Unmolsharma/QKDCubesat-TimingSync-FPGA/(commit log)

2026-09-26 Step 1: carry-chain delay line model, sync stage, popcount encoder
    - tdc_delay_line: CARRY4+FDRE under `ifdef SYNTHESIS (hit enters via CYINIT,
    the only fabric-reachable carry input on 7-series); seeded behavioural
    threshold model otherwise (22 ps nominal, wide/near-zero bins, per-tap
    skew -> bubbles, per-sample jitter)
    - tdc_sync: second register stage (ASYNC_REG)
    - tdc_encoder: 3-stage pipelined popcount (bubble-tolerant)
    - tdc_frontend: wraps the above with aligned t0/zero/full flags
    - cocotb runner (no make) with default / nojitter / fast_corner configs
    - tests: smoke, sweep/monotonicity, coverage (fast corner is an expected
    failure demonstrating that 192 taps do not always cover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
    [tdc_delay_line.v, tdc_encoder.v, tdc_frontend.v, tdc_sync.v]
2026-09-26 Step 2: coarse counter, hit detector, calibration LUT hook, tdc_top
    - tdc_coarse_counter: free-running, delayed to match the frontend latency
    - tdc_hit_detect: tap-0 trigger, holds the candidate until the line is seen
    full (proves pulse > chain; short pulses flagged, never emitted),
    saturation (coverage) and re-trigger counters, dead-time handling
    - tdc_calib_lut: fine -> ps, ideal linear default, $readmemh, runtime write
    - tdc_top: valid/ready stream {coarse,fine} + {coarse,fine_ps}, drop+count
    - delay-line model: mask/binary-search evaluation (bit-identical, faster)
    - tests: smoke, boundary, multi-hit + dead time, short pulse, back-pressure,
    top-level coverage, code-density data coll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
    [tdc_calib_lut.v, tdc_coarse_counter.v, tdc_delay_line.v, tdc_frontend.v, tdc_hit_detect.v, tdc_top.v]
2026-09-26 Step 3: code-density calibration, analysis, simulated results
    - scripts/calibrate.py: code-density test -> bin widths, DNL, INL,
    bin-centre LUT (.mem for $readmemh); simple one-code-per-line input
    - scripts/analyze.py: histogram, widths (vs model ground truth), DNL, INL,
    RMS before/after calibration validated on an independent data set
    - runner: "calibrated" config loads the generated LUT into the RTL and
    checks it end to end; tighter boundary tolerance
    - README: architecture, time convention, assumptions, coverage risk,
    SIMULATED results table (calibrated RMS 11.7 ps, residual INL 0.29 LSB)
    [analyze.py, calibrate.py]
2026-09-26 Step 4: UART readout, ring-oscillator hit source, board wrapper, capture.py
    - tdc_uart_tx / tdc_uart_readout: 2 Mbaud 8N1 (exact from 250 MHz),
    self-synchronising frames (FINE / TIMESTAMP / STATUS), BRAM FIFO,
    back-pressure -> drop+count in tdc_top, periodic status frames
    - tdc_ring_osc: LUT ring + ripple divider (DONT_TOUCH, combinational-loop
    notes), simulation stand-in behind `ifndef SYNTHESIS
    - tdc_arty_top: MMCM 100->250 MHz, sw0 hit source, sw1 UART mode,
    sticky drop/short/saturation LEDs
    - scripts/capture.py: pyserial capture + offline re-parse -> calibrate.py CSV
    - tests: timestamp burst with FIFO overflow (frames == TDC stream, sent +
    dropped == hits, capture.py CLI on the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
    [capture.py, tdc_arty_top.v, tdc_ring_osc.v, tdc_uart_readout.v, tdc_uart_tx.v]
2026-09-26 Step 5: XDC, chain placement, Vivado build script, lab guide
    - constraints/tdc_arty_a7.xdc: board + MMCM clocks, ring-oscillator clock
    and combinational-loop waiver, false path through the chain's CYINIT
    (with rationale), DONT_TOUCH/ASYNC_REG, single-column single-region
    pblock, Arty A7 pins
    - constraints/tdc_chain_place.tcl: LOC/BEL for every CARRY4 and capture FF
    derived from the pblock; post-route contiguity/clock-region check
    - scripts/build.tcl: portable non-project flow (part=/lut= args), reports,
    chain_placement.rpt, summary.txt with WNS/Fmax, bitstream
    - docs/LAB_BUILD.md, sim/Makefile, README readout + spec-deviation notes,
    results refreshed from a clean full regression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
    [tdc_arty_a7.xdc]
2026-10-06 Step 0: restructure for block 2, chain-delay report in build.tcl
    - Block 1 RTL moves to rtl/tdc/, board wrapper + UART to rtl/top/,
    block 1 tests to sim/tdc/. New dirs for rtl/nco, sim/nco,
    sim/integration and model/ (Python reference models).
    - run_tests.py: RTL is every .v under rtl/; suites carry their block
    directory; new --block filter. Full block 1 regression passes
    unchanged after the move (same missing-code and coverage numbers).
    - build.tcl: reads rtl/*/*.v; after routing, sums the static-timing
    delay CYINIT(#0) -> CO[3](#47) at the fast corner (min) and slow
    corner (max), writes build/reports/chain_delay.rpt with a per-CARRY4
    breakdown and a report_timing cross-check,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
    [calibrate.py, capture.py, tdc_arty_top.v, tdc_calib_lut.v, tdc_coarse_counter.v, tdc_delay_line.v, tdc_encoder.v]
2026-10-19 Block 2 step 1: float loop model, gain choice, acquisition and Doppler sweeps
    model/hitgen.py: sparse photon stream generator (ppm offset + Doppler ramp,
    per-slot detection probability down to 1e-5, Gaussian jitter, dark counts,
    signal gaps, TDC dead time, offered vs accepted rates).
    model/loop_float.py: per-hit type-2 PI loop with shift-only gains
    (Ki = Kp^2/2), hit-rate gain scaling, noise gate, e^2 lock detector and
    signed-error slip detector, plus the sweeps and plots (all SIMULATED):
    - lock success / time vs detection rate at +/-100 ppm and +/-1 ppm
    - max tracking error vs accepted rate for a 0.4 ppm/s ramp at 500 MHz
    - a typical lock trace
    Design changes the model forced (documented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
2026-10-19 Block 2 step 2: bit- and cycle-exact fixed-point loop model
    model/loop_fixed.py is the golden reference the RTL must match on every hit.
    It pins all widths (88-bit phase = 48-bit slot + 40 fraction; frequency in
    slots/ps, signed 48 bit, 2^-56, so phase interpolation is one multiply;
    25-bit phase error; 32-bit e^2 average), round-half-up on every dropped bit
    except three documented floor truncations, and the exact cycle on which each
    register changes (release rule, 6-cycle correction latency, POP_GAP = 2 so
    each hit sees the previous hit's decisions, per-cycle no-hit timeout).
    Sanity run on generated streams agrees with the float model: lock after
    ~420 hits, one constant slot offset after lo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
2026-10-19 Block 2 step 3: NCO RTL (align, core, phase det, gate, loop filter, lock det) + tests
    rtl/nco/: nco_align (hold-until-due FIFO, exact late release fine' = fine +
    j*T up to J_MAX = 12, POP_GAP = 2, late count), nco_core (88-bit phase,
    frequency in slots/ps, constant x4000 increment, documented valid-strobed
    external correction port), nco_phase_det (one 25x17 multiply, wrap, slot,
    e^2, residual ps), nco_gate (2g ceiling documented), nco_loop_filter (shift-
    only PI, Ki = Kp^2/2, gear ramp, power-of-two hit-rate scaling with
    override), nco_lock_det (ACQ/RAMP/LOCK, dual-weight e^2 average, reject run,
    per-cycle no-hit timeout, signed-error slip suspicion forcing unlock,
    counters), nco_top (valid/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
    [nco_align.v, nco_core.v, nco_gate.v, nco_lock_det.v, nco_loop_filter.v, nco_phase_det.v, nco_tb_top.v]
2026-10-19 Block 2 step 4: 48-bit TDC time base, telemetry framing, TDC->NCO integration, README
    - tdc_coarse_counter / tdc_top / tdc_hit_detect: COARSE_W 32 -> 48 (wraps after
    13 days instead of 17.2 s, so every timestamp of a ~6 min pass is unique).
    Block 1 tests are width-generic and pass unchanged.
    - tdc_uart_readout: TIMESTAMP frame 7 -> 9 bytes (48-bit coarse); new type 3
    TELEMETRY frame (25 bytes, 173-bit loop state/frequency/averages/counters),
    sent after each STATUS frame when tlm_en is set (tied off in the block 1
    wrapper). scripts/capture.py decodes it (--tlm-out, --f-src).
    - sim/integration: behavioural carry-chain TDC -> nco_top through the
    valid/ready interface, NCO time base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
2026-10-20 Block 2: operating limits (jitter, dark counts, SPAD tail) from the float model
    model/hitgen.py: optional SPAD diffusion tail (tail_frac of detections get an
    extra exponential delay, mean tail_tau_ps). Off by default; streams without
    it are unchanged (NCO RTL suite re-run: all PASS, still bit-exact).
    model/loop_limits.py (SIMULATED, 16 trials/point, +/-100 ppm, ~1e5 photons/s):
    - max photon jitter that locks with 0 slips: 100 MHz 1200 ps default /
    1600 ps tuned; 500 MHz 210 ps default / 350 ps tuned (tuned = gate 1/4,
    lock 1/20, unlock 0.07; runtime inputs only). 150 ps Si SPAD at 500 MHz:
    100 % lock, 0 slips, but the default gate flags ~10 % of real photons ->
    use gate 1/4 for M2.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
2026-10-20 Phase 2 step 1: satellite emulator on its own clock + statistics test
    rtl/top/sat_emulator.v: independent source clock domain (waveform generator
    on hardware, offset/drifting clock in simulation); each slot is detected
    with probability p_thr/2^32 using a 32-bit xorshift generator; 15 ns
    (1.5-period) pulse via an output DDR register; a slot right after an emitted
    one is suppressed (pulses would overlap); true slot index of every pulse on
    a side channel; drop_all for signal gaps; synchronised controls.
    The first draft used a plain LFSR. Its consecutive states are shifted copies,
    so "state < threshold" fired in clusters (adjacent-pair rate 5.2e-3 vs
    p^2 = 1e-4 at p = 1e-2: 175 sigma; the first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
    [sat_emulator.v]
2026-10-20 Phase 2 step 2: M1 board top, M1 rehearsal in simulation, lab procedure
    rtl/top/m1_arty_top.v: emulator (jb[0] clock) -> Pmod JA2 -> jumper -> JA1
    -> tdc_top -> nco_top -> UART STATUS + TELEMETRY; switches for detection
    probability, signal gap and raw timestamps; LEDs for lock and unlock-seen.
    constraints/m1_arty_a7.xdc + build.tcl top=m1_arty_top (not yet run in
    Vivado; emulator clock and pulse pins flagged for checking).
    sim/integration/test_m1.py, run from scratch with the fixed emulator
    (+20 ppm emulator clock, p = 1e-2, SIMULATED): lock 395 us (375 hits;
    float model ~420), frequency +20.018 ppm mean / 0.046 ppm RMS vs +20.000,
    0 slips over 1901 locked photons vs the emulator's true slo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
    [m1_arty_top.v, m1_tb_top.v]
2026-10-21 Step 3a: UART command path for the NCO runtime settings; pins checked
    PC -> board commands on the Arty USB-UART RX pin (A9, uart_txd_in), 2 Mbaud:
    8-byte frames A5 | 'W'/'R' | addr | data[31:0] | XOR checksum, with an idle
    timeout that drops partial frames. Every command is answered with a READBACK
    frame (the 25-byte type-3 frame, spare bits = 01; telemetry keeps 00):
    register value after the command, status (ok / bad checksum / bad or
    read-only address / bad command) and a sequence number.
    - rtl/top/uart_rx.v: 8N1 receiver, centre sampling, framing-error count.
    - rtl/top/nco_cfg_regs.v: parser + register file (gate, lock/unlock
    thresholds, averaging shifts, tau override, gears, rej_max, t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
    [capture.py, m1_arty_top.v, m1_tb_top.v, nco_cfg_regs.v, nco_cmd_tb_top.v, nco_config.py]
2026-10-21 Step 3a docs: M1_DEMO pin table (verified) and run-time settings, README
    The step 3a commit (8f56581) said these docs were updated, but the doc patch
    had failed on a line-wrap mismatch and was not part of it. This adds them:
    pin table checked against Digilent's Arty-A7-100-Master.xdc (E15 SRCC
    clock-capable, B11, A9), nco_config.py usage and settings table, and the
    README note on the command path. Documentation only.
2026-10-21 Phase 3 step 1: per-channel calibration tools and N-chain placement
    - calibrate.py / analyze.py: --code-col, --channel-col, --channel select one
    channel's codes from "ch,fine[,tau]" files; calibrate.py --per-channel DIR
    writes one DIR/ch<i>.mem (+ .json) per channel, the names tdc_multi_top's
    LUT_DIR reads. Single-channel files work as before (LUT byte-identical).
    Docstring notes that ring-oscillator (or any on-chip) calibration must be
    checked per channel.
    - tdc_chain_place.tcl: channel i (ch[i] hierarchy, no prefix = channel 0)
    goes in pblock column x0 + i; refuses a pblock whose width differs from the
    channel count; the placement check runs per chain and requires all chains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
    [analyze.py, calibrate.py, tdc_arty_a7.xdc]
2026-10-21 Phase 3 step 2: multi-channel TDC (NUM_CH = 5), merged time-ordered stream
    rtl/tdc/tdc_multi_top.v: NUM_CH copies of block 1's channel (48-CARRY4
    chain, sync, encoder, hit detect, own calibration LUT LUT_DIR/ch<i>.mem,
    8-deep FIFO with per-channel drop counter) on ONE shared coarse counter.
    The merger releases a FIFO head once no channel can still deliver an earlier
    hit (coarse_now >= c + MAXLAT + 2) and emits the smallest calibrated time
    c*T - fine_ps: the stream {ch, coarse, fine, fine_ps} is sorted by measured
    time, with valid/ready back-pressure. Limits documented: near-simultaneous
    hits within resolution + uncorrected skew may swap; one output per clock.
    NUM_CH = 1 works; tdc_top and th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
    [tdc_multi_top.v]
2026-11-04 nco_core: one initial value for fclk; LAB_BUILD: tdc_arty_top calibrates offline
    fclk was initialised twice (declaration = 0 and initial = fclk_nom). Yosys
    rejects that, and both flows should read the same source. Reset loads fclk_nom
    too, so behaviour after reset is unchanged.
    LAB_BUILD step 6: tdc_arty_top streams m_raw and leaves m_cal unconnected, so
    calibrate.py/analyze.py apply the table offline. lut= only matters for
    m1_arty_top.
    [nco_core.v]
2026-11-04 Preliminary open-source build: Yosys + nextpnr-xilinx 0.9.8 for both board tops
    scripts/open_build.sh builds tdc_arty_top and m1_arty_top in a pinned Docker
    image, alongside the unchanged Vivado flow. open_flow.py turns the XDC and chain
    placement into BEL attributes and nextpnr XDC, records what became of every
    constraint, and proves the built chain from the routed netlist and FASM. No
    bitstream if the structural checks fail. Outputs are labelled PRELIMINARY.
    First result: neither top meets 250 MHz in this flow (tdc_arty_top about 151 MHz,
    m1_arty_top about 27 MHz). No bitstream has been run on a board.
    [open_flow.py, test_open_flow.py]
2026-11-10 Pipeline the NCO for 250 MHz; float latency check; per-endpoint open STA
    RTL: no carry chain wider than about 24 bits per cycle. D = 20, J_MAX = 24,
    POP_GAP = 8 (sustained limit 31.25 Mhit/s, was 125). Corrections land at
    n+18 (phase) and n+15 (frequency), and fclk 7 clocks after fps.
    model/loop_fixed.py follows cycle for cycle.
    Fix a stale carry into the high half of the lock detector's mse update,
    found by the UART UNLOCK case. The testbench now also compares mse and sgn
    on every hit.
    model/loop_float.py: optional RTL transport delay and a latency sweep
    (--only latency). No slips or unlocks at RTL delay. Time to lock worsens
    only in high-rate stress corners; see README "Loop latency".
    s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
    [nco_align.v, nco_core.v, nco_gate.v, nco_lock_det.v, nco_loop_filter.v, nco_phase_det.v]
2026-11-10 Fanout fixes without extra loop delay; pipelined reset trees
    Leaving ACQ/RAMP/LOCK used to clear ~60 registers from one combinational
    to_acq net (the no-hit timeout flag was the worst path, -4.4 ns). Now only
    state and the output lock flag change in the same cycle; the rest clear from
    a per-block register one cycle later, still no later than the next hit's E
    stage. The timeout is decided a cycle early on t_nco + 1 (c_last taken at
    F-1) so it acts in the same cycle as before, and its mask-and-OR is one
    compare. Counters count from registered events. loop_fixed.py is unchanged
    (comment only); every hit is still bit-exact.
    Reset: rst_tree.v gives each block its own tap in both board tops and i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
    [m1_arty_top.v, nco_align.v, nco_cfg_regs.v, nco_core.v, nco_lock_det.v, nco_loop_filter.v]
2026-11-10 Five merged channels against the 31.25 Mhit/s NCO limit
    model/merge_limit.py: 4 quantum + 1 sync channel, per-channel dead time,
    tdc_multi_top's merger, the NCO FIFO, then loop_fixed.py itself.
    test_five_channel_merge replays two streams into nco_top: results and late
    drops bit-exact. Realistic rates lose nothing; 20 Mcps loses 3 %; above the
    cap throughput collapses because late hits still use a release slot; a
    5-channel coincidence always loses its 5th hit. README table. SIMULATED.
2026-11-10 NCO admission: late hits cost nothing; coincidences delivered whole
    Steps 1 and 2. nco_align now decides admission before the FIFO, in three
    pipeline stages with 10-bit relative counters (release cycle predicted as
    n = max(c, a + 9, n_prev + 8)):
    - j <= J_LOOP (24): released, the loop uses it.
    - 24 < j <= J_MAX (56), within 48 clocks of the last loop hit: released as
    stale. Slot, error, residual and output as usual, but every loop strobe is
    masked, so no loop delay is added.
    - otherwise: dropped before the FIFO, counted late, takes no release slot.
    D goes from 20 to 23 to absorb the three admission stages, so the loop timing
    is unchanged. fine' is 18 bits now; nco_phase_det takes the to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
    [nco_align.v, nco_phase_det.v, nco_top.v]
2026-11-10 TDC: pipeline the popcount encoder (5 stages); NCO lag D = 30
    Step 3. The encoder's stage 2 added eight 3-bit counts in one cycle (7 logic
    levels, the worst path of the board build). Now: pop6, pairs, pairs, groups
    of 4, final sum; no stage adds more than 4 small numbers. Front-end latency
    4 -> 6 clocks; tdc_top / tdc_multi_top LATENCY and the coarse alignment line
    follow, so timestamps are unchanged. Merger MAXLAT 12 -> 14.
    The NCO absorbs it: D 23 -> 30, so a merged hit (up to 21 clocks after its
    edge) is still released at j = 0. merge_limit.py (CH_LAT 11, MAXLAT 14,
    D 30) gives the same drops as before in every scenario. Testbench LAT 9 -> 11,
    test_frontend LATENCY 6.
2026-11-10 NCO: pipeline the slip-threshold and timeout compares
    Step 4. Neither is in the loop feedback path, and both decide in exactly the
    same cycles as before, so model/loop_fixed.py is unchanged:
    - slip flags: slip_thr registered locally (it came straight from the config
    block), each 25-bit compare split into 13/12-bit halves over two cycles;
    ready at E+4, used at F = E+6.
    - no-hit timeout: arithmetic two cycles ahead on t_nco + 2; idle low/high,
    eight partial ORs of (idle & mask), final OR. mask = ~(2^s - 1) decoded
    straight from L + to_shift. c_last taken at F-2 (still inside the blocked
    window).
    test_gap_reacquire (timeout unlock) is bit-exact.
    [nco_lock_det.v, nco_top.v]
2026-11-11 UART, settings and telemetry on a 50 MHz serial clock with proper CDC
    Step 5. Both board tops take a second MMCM output, CLKOUT1 = 1000 MHz / 20 =
    50 MHz (CLKS_PER_BIT 25: still exactly 2 Mbaud). On it: uart_rx, nco_cfg_regs,
    and the tdc_uart_readout framer and transmitter. TDC, NCO and LEDs stay at
    250 MHz. Crossings:
    - raw timestamps: async_fifo.v (gray pointers through ASYNC_REG pairs,
    registered conservative w_ready, all 2^AW entries usable)
    - drop/short/sat counters and the 173-bit telemetry word (250 -> 50) and the
    137 bits of NCO settings (50 -> 250): cdc_snapshot.v, a toggle handshake
    that keeps a coherent copy refreshed every few destination cycles; the
    settings start at the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
    [async_fifo.v, cdc_snapshot.v, m1_arty_top.v, m1_tb_top.v, nco_cmd_tb_top.v, open_flow.py, tdc_arty_a7.xdc]
2026-11-11 NCO: take the admission and stale-mask logic off M1's critical paths
    The first open build after steps 1-5 put the new logic on M1's worst paths
    (PRELIMINARY nextpnr model, seed 1): late_cnt CE -5.2 ns, the admission
    precompute p_m7 -3.6 ns (12 levels), FIFO write pointer -2.8 ns, and the
    stale-masked counters -2.6 to -2.8 ns.
    - nco_align: every precompute is now one add or compare straight from the
    saturated x; the admit decision is registered and the FIFO write, late
    pulse and late_cnt happen one cycle later (a+4). Earliest release a + 10.
    - nco_top: the stale-masked loop strobes (e_valid, commit/c_last, F) are
    registers computed one stage early: no extra logic level.
    - D 30 -> 31 abs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
2026-11-11 NCO admission: one more stage so each flag is a single compare
    Seed 3 of the previous commit moved the worst path to the flag logic itself
    (q -> max(q-1,-2) -> + x -> compare: 11 levels, -4.3 ns PRELIMINARY). Now:
    - a+2 computes every per-hit threshold (constant - x) as a register;
    - a+3 makes each flag one register-to-register compare, against q, a separate
    qn = max(q - 1, -2) register, r, and the hit ahead's p_q / x_r;
    - a+4 decides (a select), a+5 writes. Earliest release a + 11.
    D 31 -> 32 and ALIGN_LAT 10 -> 11 keep j unchanged. Same function:
    merge_limit.py gives the same drops at all realistic and stress rates;
    test_coincidences, test_coincident_and_late, test_five_channel_merge,
    te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
2026-11-11 NCO align: decision copy off the high-fanout net; 32-entry FIFO, simple s_ready
    M1 seed 1 (PRELIMINARY) after the previous commit: the registered decision
    adm5 -> drop5 at -3.6 ns, 4 logic stages but a high-fanout net (FIFO write
    enable, pointer, count, and the next decision), and tdc_ready at -2.4 ns from
    the FIFO occupancy plus five in-flight valids.
    - the next decision selects on its own copy of the decision register (adm_p),
    which synthesis can't merge with adm5;
    - FIFO 16 -> 32 entries (same RAM32M LUT RAM); s_ready = occupancy <= 24,
    the margin covering the 5 admission stages and the registered handshake.
    merge_limit.py: same drops at realistic and stress rates; at overload the NCO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
2026-11-11 Open build: both tops, seeds 1-3, after steps 1-5 (PRELIMINARY)
    tdc_arty_top: worst slack -1.02 / -0.57 / -0.42 ns (~199-226 MHz, was ~174).
    m1_arty_top: -3.21 / -2.62 / -2.57 ns (~138-152 MHz, was ~132 on seed 1).
    clk_ser (50 MHz) passes on both. Remaining worst groups listed; none meets
    250 MHz in this flow. nextpnr does not honor set_max_delay: the clk_sys/clk_ser
    crossings are listed, not checked.
